zazachubin/RD53B_Quad_ZIF_to_ERF8_Data_Adapter/Images/Design/ZIF_card.png

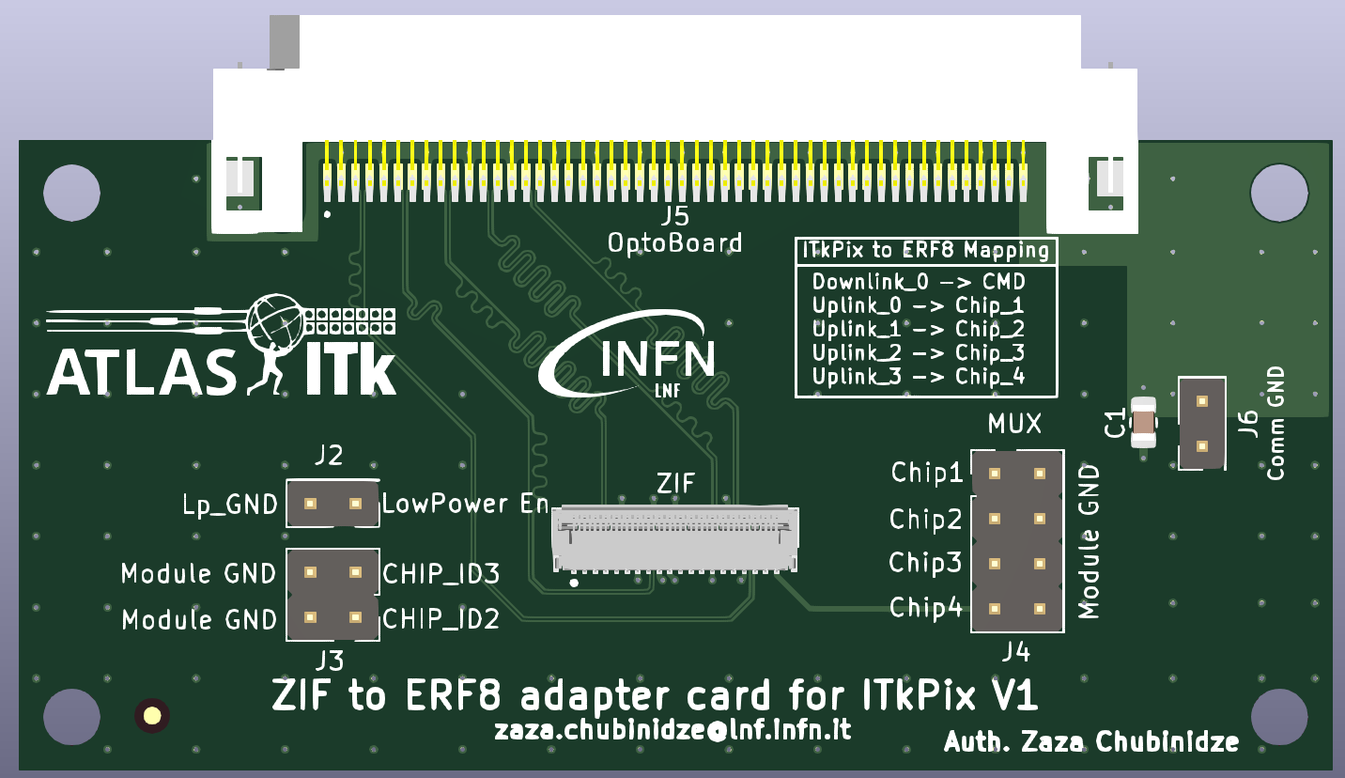
Images/Design/ZIF_card.png
