zazachubin/RD53B_Quad_ZIF_to_ERF8_Data_Adapter/Docs/RD53B_Quad_ZIF_to_ERF8_Data_Adapter.pdf

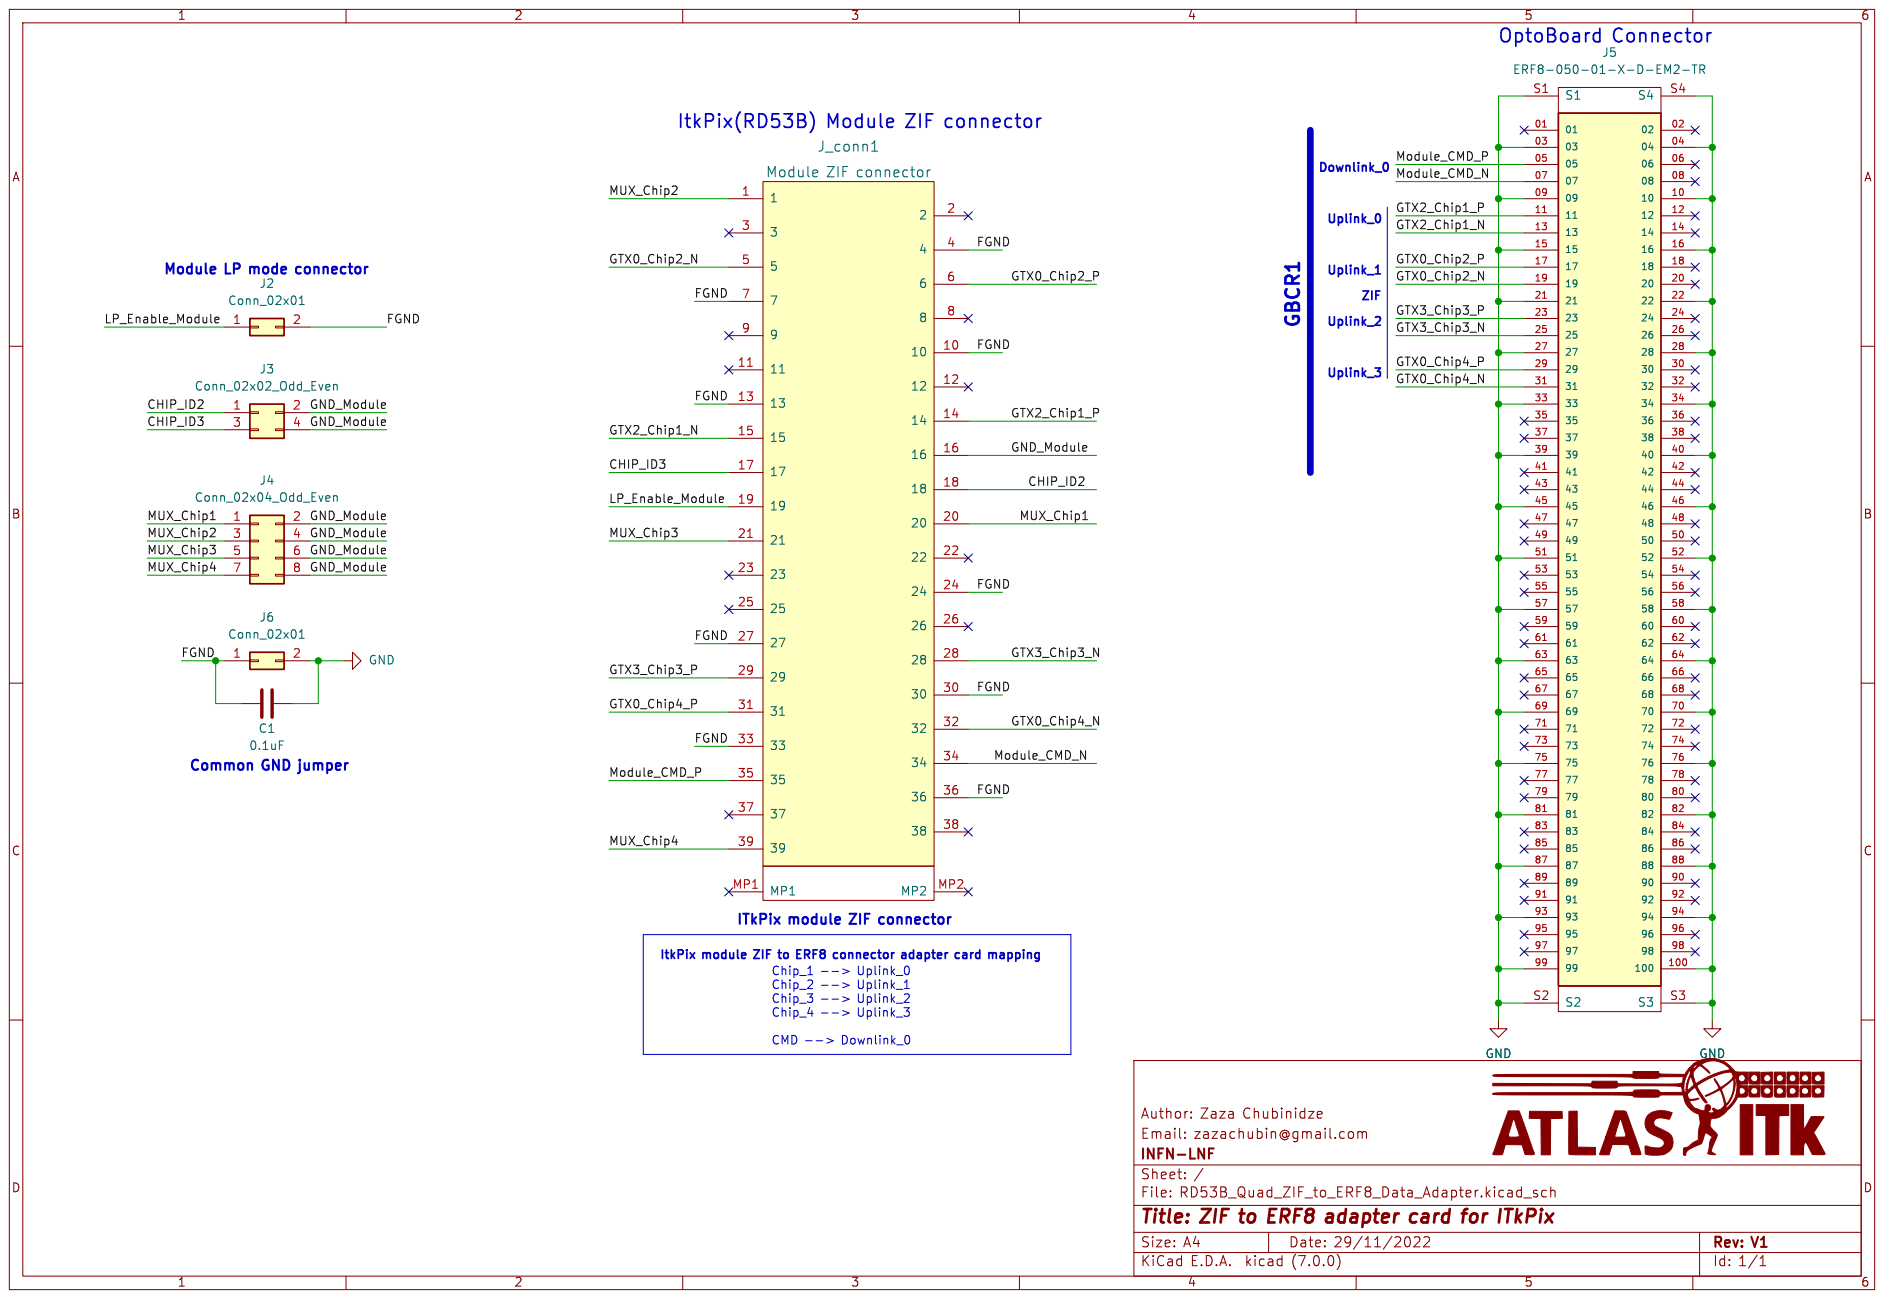
[picture p3: page 1]

ItkPix(RD53B) Module ZIF connector

Uplink_0 Downlink_0 Common GND jumper Module LP mode connector

ItkPix module ZIF to ERF8 connector adapter card mapping

INFN-LNF Email: zazachubin@gmail.com

File: RD53B_Quad_ZIF_to_ERF8_Data_Adapter.kicad_sch Sheet: /
Id: 1/1 Title: ZIF to ERF8 adapter card for ITkPix
