zazachubin/RD53B_Quad_ZIF_to_ERF8_Data_Adapter/(commit log)

2023-01-20 Initial project
    [RD53B_Quad_ZIF_to_ERF8_Data_Adapter.kicad_pcb, RD53B_Quad_ZIF_to_ERF8_Data_Adapter.kicad_sch]
2023-01-20 Add PCB holes
    [RD53B_Quad_ZIF_to_ERF8_Data_Adapter.kicad_pcb]
2023-01-20 Remove biase resistors and change optoboard grounding
    [RD53B_Quad_ZIF_to_ERF8_Data_Adapter.kicad_pcb, RD53B_Quad_ZIF_to_ERF8_Data_Adapter.kicad_sch]
2023-02-05 Trace length matching for all channels
    [RD53B_Quad_ZIF_to_ERF8_Data_Adapter.kicad_pcb]
2023-02-05 Change common and floating ground layout
    [RD53B_Quad_ZIF_to_ERF8_Data_Adapter.kicad_pcb]
2023-02-05 Revision 1
    [RD53B_Quad_ZIF_to_ERF8_Data_Adapter.kicad_pcb]
2023-02-12 Add return ground vias
    [RD53B_Quad_ZIF_to_ERF8_Data_Adapter.kicad_pcb]
2023-02-20 Add PCB production files
    [RD53B_Quad_ZIF_to_ERF8_Data_Adapter.kicad_pcb]
2023-02-20 Update KiCad version 7.0
    [RD53B_Quad_ZIF_to_ERF8_Data_Adapter.kicad_pcb, RD53B_Quad_ZIF_to_ERF8_Data_Adapter.kicad_sch]
2023-05-06 The return ground improvement
    [RD53B_Quad_ZIF_to_ERF8_Data_Adapter.kicad_pcb]
2023-08-29 Change mapping to master LpGBT
    [RD53B_Quad_ZIF_to_ERF8_Data_Adapter.kicad_pcb, RD53B_Quad_ZIF_to_ERF8_Data_Adapter.kicad_sch]
2023-08-31 Update gerber files
    [RD53B_Quad_ZIF_to_ERF8_Data_Adapter-B_Cu.gbr, RD53B_Quad_ZIF_to_ERF8_Data_Adapter-B_Fab.gbr, RD53B_Quad_ZIF_to_ERF8_Data_Adapter-B_Mask.gbr, RD53B_Quad_ZIF_to_ERF8_Data_Adapter-B_Paste.gbr, RD53B_Quad_ZIF_to_ERF8_Data_Adapter-B_Silkscreen.gbr, RD53B_Quad_ZIF_to_ERF8_Data_Adapter-Edge_Cuts.gbr, RD53B_Quad_ZIF_to_ERF8_Data_Adapter-F_Cu.gbr, RD53B_Quad_ZIF_to_ERF8_Data_Adapter-F_Fab.gbr]
